IlyaBOT/Logic-Analyzer-Clock-Divider/previews/pcb_3d_back.png

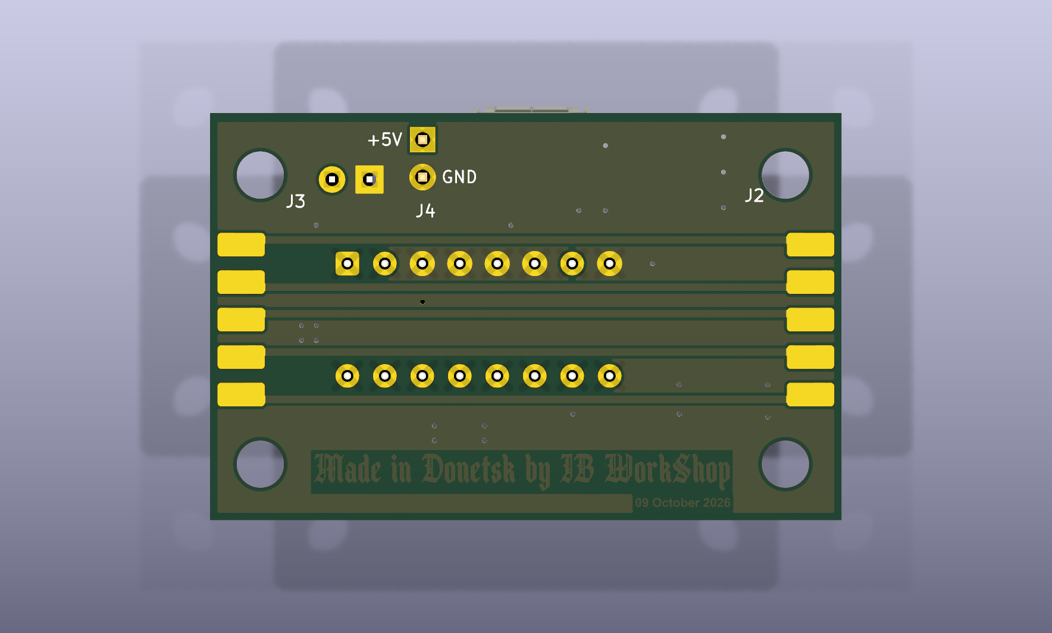
previews/pcb_3d_back.png
