IlyaBOT/Logic-Analyzer-Clock-Divider/previews/pcb_3d.png

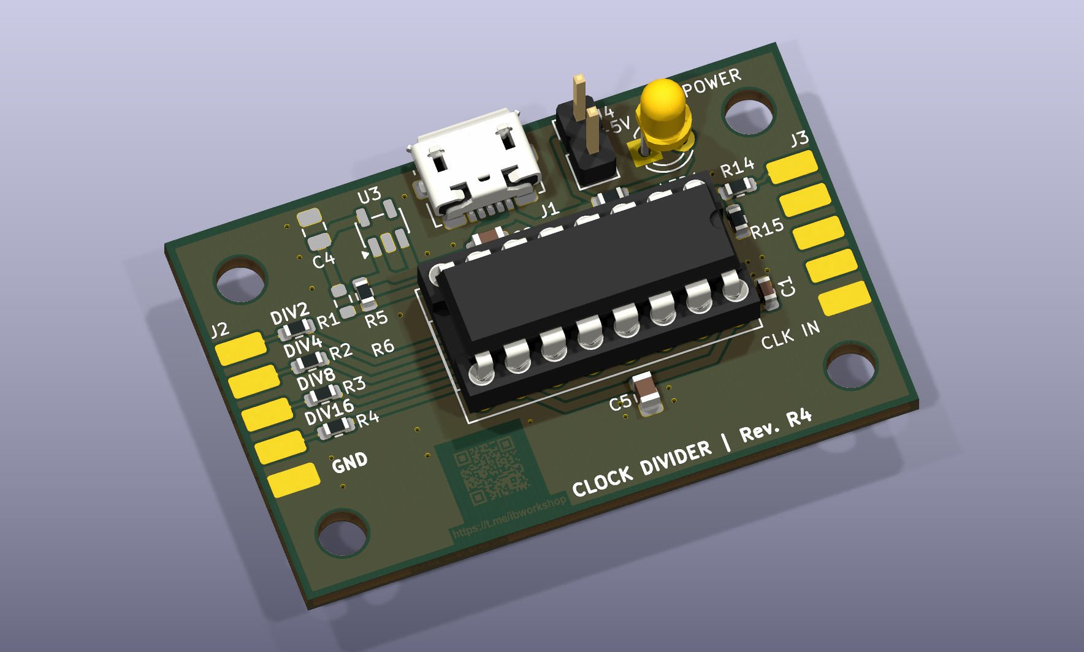
previews/pcb_3d.png
