IlyaBOT/Logic-Analyzer-Clock-Divider/README.md

# ACT161 Frequency Divider - R4

Основная редактируемая ревизия R4, KiCad 10.0.6, обновлена 2026-10-09. Прежняя папка R3 удалена. Взята ваша ручная разводка R4: все её дорожки/via, положения компонентов и контур сохранены. Текущий размер платы 42.8x27.6x1.6mm; два слоя, DIP-16/SCS-16 и четыре отверстия M3.

**До изготовления: оба торцевых разъёма UNVERIFIED, реальная распиновка/уровни анализатора неизвестны. Аппаратных измерений на 80MHz нет.**

Открыть `ACT161_Frequency_Divider.kicad_pro` в KiCad 10 или совместимой новой версии. Переносить всю папку: символы, footprint и модели локальные, пути `${KIPRJMOD}`. Схема и PCB нативные; генераторы не нужны для ручного редактирования.

## Изменения R4

J2 расположен на левой кромке, J3 - на правой. У каждого пять SMD-площадок F.Cu и пять B.Cu, без отверстий и без пасты. J3 больше не является нижним THT-разъёмом. Нечётные контакты обоих разъёмов на F.Cu, чётные на B.Cu; строки 1/2 сверху. Механические модели этих разъёмов отсутствуют: выполнена 2D-проверка, посадка реальных деталей не подтверждена.

SN74LVC125APW, C3 и выходные селекторные резисторы удалены. R1-R4=47R соединяют QA/QB/QC/QD напрямую с DIV2/4/8/16. По умолчанию U1 CD74ACT161E получает 5V через R5=0R; R6, U3, C4 не устанавливаются. LED питается от общей входной шины 5V (USB или J4). Пять PASS проходят напрямую между одинаковыми номерами J2/J3. USB +5V не соединено с контактами J2/J3.

## Питание проводами через J4

Между Micro-USB J1 и LED1 установлена вертикальная штыревая гребёнка J4 1x2, шаг 2.54mm, отверстия 1mm. При виде сверху, USB наверху: верхний квадратный контакт 1 = +5V, нижний круглый контакт 2 = GND. Полярность подписана на плате. Гребёнка включена в BOM и в схему, footprint и STEP локальные.

Подать стабилизированные 5V и общий GND от основной схемы. USB и J4 соединены с одной шиной напрямую: использовать только один источник за раз. При питании через J4 отключить USB-кабель, иначе питание может попасть в USB-порт. В опциональной сборке с выходами 3.3V на J4 по-прежнему подаются 5V; это вход до U3. LED работает от любого из этих двух входов.

В исходной R4 дополнены пять незавершённых соединений у J2/J3, исправлены пересечения/размер надписей и расстояние между QR и ссылкой. Исходные нативные файлы сохранены в `reports/user_R4_original.zip`; сравнение геометрии - `input_user_layout.json` и тест сохранения пользовательской разводки.

## Опция 3.3V без выходного буфера

Это отдельный вариант сборки с заменой U1, а не переключение напряжения установленного ACT161. При выключенном питании удалить R5, заменить CD74ACT161E в панельке на совместимый по выводам CD74AC161E, установить U3 TLV75533PDBVR, C4 и R6=0R. Все управляющие входы и развязка U1 питаются от выбранного VCC_LOGIC. Одновременно R5/R6 не устанавливать: это соединит 5V с выходом 3.3V стабилизатора.

CD74ACT161E требует 4.5-5.5V и не допускается в сборке 3.3V. Для CD74AC161E при 3.3V datasheet гарантирует до 64MHz (-55..125C), 73MHz (-40..85C), а не 80MHz. CLK должен быть 0..VCC и с полными CMOS-уровнями; 5V CLK напрямую запрещён в режиме 3.3V. Если 3.3V выходы нужны при 80MHz с сохранением ACT161, потребуется внешний преобразователь уровней либо отдельная переработка схемы. Источники и временные параметры в `reports/validation.md`.

## Проверки и файлы

Сохранённые ERC/DRC, 15 успешных тестов и `final_audit.txt` в `reports/` относятся к снимку из `checked_sha256.json`. Текущие PCB и `.kicad_pro` отличаются от этого снимка. Повторная проверка 2026-10-17: ERC без нарушений; DRC без ошибок, с одним предупреждением о несовпадении J4 с библиотечным footprint; тесты 13/15, два расхождения с прежней компоновкой. Подробности и список файлов для очистки — `reports/repository_audit.md`. Прежняя проверка переноса выполнялась в другой папке на этом же ПК, не на другой машине.

`docs/` содержит PDF схемы, двух copper и двух assembly видов, а также `pinout.md`. `previews/` содержит PNG, SVG каждого слоя и два настоящих 3D-рендера KiCad. BOM и варианты сборки в `reports/BOM.csv` и `assembly_variants.json`.

Чертежи и изображения относятся к исходникам, записанным в `reports/export_manifest.json`; после изменений PCB их нужно обновить. `.gitignore` исключает автокопии и локальные настройки KiCad, файлы Freerouting, кэши Python, старые генераторы и их логи. Нативные файлы, локальные библиотеки, документация, актуальные отчёты и `reports/user_R4_original.zip` остаются доступными для Git.

`scripts/check_native.py` запускает ERC/DRC/tests в этой установке KiCad. Старые генераторы `design.py` и `build_pcb.py` заблокированы от запуска, чтобы не перезаписать вашу ручную разводку. Нативные KiCad-файлы - основной источник проекта. `export.py` обновляет чертежи, `document.py` документацию. В скриптах заданы пути к установленным здесь KiCad/Poppler.

Перед подключением проверить pinout и допустимые уровни анализатора, посадку обоих торцевых разъёмов, точную панельку и приобретённые MLCC/LED. Подавать CLK после стабилизации питания; измерять питание и CLK у U1.2, начинать с низкой частоты. Выходы рассчитаны на высокоомные входы, не на DC-нагрузку 50ohm. В фазе включения счётчика нет определённого сброса. Прямой счёт 433MHz не предусмотрен. Gerber/Drill не выпускались, изготовление не заказывалось.
