IlyaBOT/Logic-Analyzer-Clock-Divider/docs/pinout.md

# Контакты, стороны и варианты R4

**До проверки документации/прозвонки конкретного анализатора J2 не подключать. Default выходы теперь 5V; 5V tolerance анализатора неизвестна.**

| Номер | J2 слева, анализатор | J3 справа, DUT |
|---|---|---|
| 1 | DIV2 | CLK_IN |
| 2 | PASS2 | PASS2 |
| 3 | DIV4 | NC |
| 4 | PASS4 | PASS4 |
| 5 | DIV8 | NC |
| 6 | PASS6 | PASS6 |
| 7 | DIV16 | NC |
| 8 | PASS8 | PASS8 |
| 9 | GND | GND |
| 10 | PASS10 | PASS10 |

PASS2/4/6/8/10 имеют только два узла J2.N/J3.N, без связи с USB-питанием, GND или счётчиком. Если контакт PASS анализатора является питанием, он напрямую попадёт на соответствующий контакт DUT: проверить возможный конфликт источников.

## Вид сверху, USB наверху

Плата 42.8x27.6mm. Координаты далее относительно верхнего левого угла: J2 - левая кромка X=0, J3 - правая X=42.8. В нативном PCB этот угол имеет координаты (126.6,84.4)mm. Оба разъёма припаяны к поверхности сверху/снизу, без отверстий. Начало координат слева сверху, Y направлен вниз.

| Строка Y, mm | J2 F.Cu | J2 B.Cu | J3 F.Cu | J3 B.Cu |
|---|---|---|---|---|
| 8.92 | 1 | 2 | 1 | 2 |
| 11.46 | 3 | 4 | 3 | 4 |
| 14.00 | 5 | 6 | 5 | 6 |
| 16.54 | 7 | 8 | 7 | 8 |
| 19.08 | 9 | 10 | 9 | 10 |

Центры J2 X=2.10, J3 X=40.70 (абсолютно 128.7 и 167.3mm). Площадки 3.20x1.60mm, шаг строк 2.54mm, край меди в 0.50mm от Edge.Cuts. Ни F.Paste, ни B.Paste нет; ручная пайка открытых площадок. J3 footprint является горизонтальным зеркалом геометрии J2 без изменения строк/номеров. Простое вращение J2 на 180 градусов поменяло бы верх/низ строк, поэтому для J3 сделан отдельный footprint.

Для вида снизу повернуть плату вокруг вертикальной оси, сохраняя USB сверху: J3 окажется слева, J2 справа, на обеих видимых поверхностях сверху вниз 2/4/6/8/10. PDF back отражён для этого вида. Эти номера относятся к площадкам PCB; порядок номеров на mating-стороне реальных разъёмов требует измерения.

U1: pin1 квадратный, вырез панельки направлен к J3. LED pin1=K, pin2=A. USB: 1 VBUS, 2 D-, 3 D+, 4 ID, 5 GND, SH экран (все SH на GND). R13=5.1k - R_LED, R14=0R - R_CLK, R15=10k - R_PD.

## J4 - альтернативный вход питания

| Контакт | Сеть | Положение при виде сверху, USB наверху |
|---|---|---|
| 1, квадратный | +5V | Верхний, X=28.40 / Y=1.80mm |
| 2, круглый | GND | Нижний, X=28.40 / Y=4.34mm |

Гребёнка 1x2, шаг 2.54mm, THT отверстия 1mm, находится между USB и LED. В нативном PCB центр pin1 (155.0,86.2)mm. Подавать стабилизированные 5V и GND. J4 напрямую связан с USB VBUS: подключать USB или J4 по отдельности, одновременно не питать. В опции 3.3V вход J4 остаётся 5V, напряжение U1 снижает U3. LED показывает наличие общей шины +5V от любого входа.

## Напряжение

| Сборка | U1 в панельке | Установить | Не устанавливать | Выходы |
|---|---|---|---|---|
| Default | CD74ACT161E | R5 | R6/U3/C4 | около 5V |
| Optional | CD74AC161E | R6/U3/C4 | R5 | около 3.3V |

Во втором варианте C4 эффективный >=1uF, U3 TLV75533PDBVR. Все изменения при отключённых USB и J4. R5 и R6 вместе запрещены; ACT161 при 3.3V запрещён. Предел второго варианта 64MHz во всём диапазоне температуры и CLK 0..VCC. Это вариант сборки с заменой IC, не рабочий переключатель напряжения. Совместимость с входами анализатора проверить в обоих случаях.

## Механика: оба UNVERIFIED

[CONNFLY DS1002](https://www.connfly.com/static/upload/file/pdf/DS1002-01.pdf) не подтверждает монтаж выбранного J2 на кромку. Для J3 не предоставлен MPN или чертёж male-разъёма такого монтажа. У обычных двухрядных разъёмов расстояние рядов 2.54mm, поверхности PCB находятся на расстоянии 1.6mm. Нужны замеры и при необходимости формовка выводов/фиксация корпуса. Проверить доступ к пайке, mating-нумерацию и удержание разъёмов. Если переделка штатных контактов непригодна, нужны предназначенные для торцевого монтажа разъёмы/переходники и повторная CAD-проверка. До этого статус изготовления HOLD.
