IlyaBOT/Logic-Analyzer-Clock-Divider/reports/repository_audit.md

# Аудит репозитория — 2026-10-17

Основной проект — нативные `ACT161_Frequency_Divider.kicad_sch`, `.kicad_pcb` и `.kicad_pro`. Локальные библиотеки, модели и их лицензия нужны для переноса проекта. `reports/user_R4_original.zip` и `input_user_layout.json` сохраняют исходную ручную разводку и базу сравнения; это полезные данные, а не временные копии.

## Очистка

Подтверждены 87 лишних или временных файлов, 8 727 313 байт. Все пути ниже заданы относительно `I:\Logic-Analyzer-Clock-Divider`:

| Путь | Файлов | Байт | Назначение |
|---|---:|---:|---|
| `ACT161_Frequency_Divider-backups/` | 78 | 8 602 977 | Автокопии KiCad до текущей ревизии |
| `scripts/__pycache__/` | 1 | 35 966 | Восстанавливаемый кэш Python |
| `reports/historical/` | 3 | 6 422 | Логи старой автоматической разводки и их описание |
| `ACT161_Frequency_Divider.kicad_prl` | 1 | 2 644 | Локальные настройки редактора |
| `temp-freerouting.dsn` | 1 | 43 163 | Промежуточный экспорт старой платы |
| `scripts/design.py` | 1 | 16 964 | Старый генератор схемы, запуск заблокирован |
| `scripts/build_pcb.py` | 1 | 13 694 | Старый генератор платы, запуск заблокирован |
| `scripts/add_power_header.py` | 1 | 5 483 | Однократная, уже применённая миграция J4 |

Действующие проверки, экспорт и документация не импортируют эти три старых скрипта. Все перечисленные пути исключены из Git. `.gitignore` также исключает новые автокопии, блокировки и автосохранения KiCad, обменные файлы Freerouting, Python-кэши, локальные окружения и системные метаданные. Полезные ZIP, PDF, STEP, изображения, JSON и отчёты общими правилами не скрываются.

**Удаление не выполнено:** автоматическая проверка отклонила как рекурсивную очистку по проверенному списку, так и удаление отдельных файлов без рекурсии. Сообщение инструмента: `rejected: blocked by policy`; более подробная причина не предоставлена. Перечисленные файлы остаются на диске. Изменён только учёт в Git и документация аудита.

## Проверка текущих исходников

Выполнены установленные KiCad CLI и Python/pcbnew, исходники платы не сохранялись и не исправлялись:

| Проверка | Результат |
|---|---|
| ERC, все уровни серьёзности | 0 нарушений, код 0 |
| DRC с проверкой соответствия схеме и пересчётом зон, без `--save-board` | 0 ошибок, 1 предупреждение, код 5 из-за `--exit-code-violations` |
| Несоединённые pads / schematic parity | 0 / 0 |
| `python.exe -B scripts/validate.py` | 13 из 15 успешно, код 1 |

Предупреждение DRC: `lib_footprint_mismatch` у J4, `PinHeader_1x02_P2.54mm_Vertical`, координаты (155.0000, 88.8000) mm. Footprint на плате отличается от локальной библиотеки. Это существовавшее до очистки расхождение.

Два упавших теста также обнаружены до изменений:

- `test_power_header_location_and_polarity`: шаг J4 по Y равен −2.54 mm вместо ожидаемых +2.54 mm. Отдельные проверки номеров контактов и сетей +5V/GND прошли до этого утверждения; ошибка относится к ориентации.
- `test_user_routing_and_placement_preserved`: одна из исходных позиций имеет Y=93.4 mm вместо 93.6 mm. Проверка всех исходных дорожек перед сравнением позиций прошла. Тест сравнивает с прежним снимком и не доказывает, что новое положение ошибочно.

Исходные отчёты CLI сохранены вне репозитория в `C:\Temp\clock-divider-audit-7d5883458e514ff1aa72f471ab3a168d\ERC.txt` и `DRC.txt`. Старые `reports/ERC.txt`, `DRC.txt`, `tests.txt`, `native_runs.json`, `portable_runs.json`, `final_audit.txt` и экспортированные изображения сохранены как результаты предыдущего снимка; повторная проверка переноса и экспорт не выполнялись.

## SHA256 на момент аудита

| Файл | SHA256 |
|---|---|
| `ACT161_Frequency_Divider.kicad_sch` | `dc645ffd8f1399dc9e17d4b2ce9c8c68495a97b33b39468b2b310f930c8ac9fd` |
| `ACT161_Frequency_Divider.kicad_pcb` | `d1fae81a477b3b5089f1d526dd3a74267afd06d627be29f03f2725eed6305038` |
| `ACT161_Frequency_Divider.kicad_pro` | `f69a45ea37f27b7f60f324420965d9941e6eb511919465da47709639cdfab9a8` |

Схема совпадает с прежним `checked_sha256.json`. Плата и проект не совпадают ни с ним, ни с `export_manifest.json`, поэтому прежние PASS и чертежи нельзя считать подтверждением текущей версии. Разводка, настройки и тестовые ожидания не менялись ради получения PASS.

После работы SHA256 всех исходных файлов совпадают с исходным состоянием, кроме намеренно обновлённых `README.md`, `reports/validation.md` и `scripts/document.py`. Нативные CAD-файлы, библиотеки, исходный ZIP, чертежи и изображения сохранены побайтно. Добавлены `.gitignore` и этот отчёт. Проверка `git check-ignore --no-index --stdin -z` подтвердила: скрыты ровно 87 перечисленных файлов, остальные 76 файлов доступны Git; дополнительно проверены 18 примеров будущих временных путей. Синтаксис шести действующих Python-скриптов и отсутствие импортов старых генераторов проверены через AST. `git diff --check` прошёл.
