IlyaBOT/Logic-Analyzer-Clock-Divider/docs/schematic.pdf

1 | 2 | 3 | 4 | 5 | 6 | 7 | 8
1 | 2 | 3 | 4 | 5 | 6 | 7 | 8

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
Size: A3 | Rev: R4 | F Date: 2026-10-09
KiCad E.D.A. 10.0.6 | Id: 1/1

# Title: 74ACT161 Frequency Divider

## File: ACT161_Frequency_Divider.kicad_sch

## Sheet: /

## Engineering prototype - UNVERIFIED edge connectors / analyzer

#FLG01 PWR_FLAG

H3 M3 / 3.2mm

1
2

J4
5V POWER INPUT

H2 M3 / 3.2mm

IN 1 GND

2

EN 3 | OUT | 5

U3
TLV75533PDBVR / 3V3 OPTION CLR 1 | CLK 2
A 3 | B
4 | C
5 | D
6
ENP 7 | GND

8

LOAD 9

ENT 10 | QD | 11 QC | 12 QB | 13 QA | 14 RCO | 15 VCC 16
U1 CD74ACT161E | R1 47R

R14
0R (0-100R option) | H1 M3 / 3.2mm

C4

4.7u / 16V X7R / DNP VBUS | 1 D- | 2 D+ | 3
ID | 4 GND

# 5 Shield SH

J1 Molex 47346-0001

LED1
YELLOW 3mm

R5
0R / 5V DEFAULT | R2
47R 1 | 2
3 | 4
5 | 6
7 | 8
9 | 10

J3 DUT / male 2x5 EDGE UNVERIFIED

R6
0R / 3V3 OPTION

C5
1u / 16V X7R

R15
10k 1 | 2
3 | 4
5 | 6
7 | 8
9 | 10

J2 DS1002-01-2x5V13-JK / EDGE UNVERIFIED

R3
47R

R4
47R

C2
4.7u / 16V X7R

C1
100n / 25V X7R

H4 M3 / 3.2mm

R13
5.1k

DIV16 GND

VCC_LOGIC +5V

PASS4

+5V | Q8Q4 GND | Q2Q16
LED_A

VCC_LOGIC

GND | +5V
VCC_LOGIC +5V | GND
VCC_LOGIC +5V | GND

GND

GND

+3V3

LED_A DIV2 GND +3V3 | DIV4
+5V +3V3 | +5V GND

GND

VCC_LOGIC

VCC_LOGIC

CLK_U1 DIV2 | PASS2 DIV4 | Q16 DIV8 DIV16 GND

PASS6

Q4 PASS8 PASS10 | CLK_IN
Q2 PASS4 | Q8 PASS6
DIV8 GND | PASS10 PASS2 PASS8
CLK_IN | CLK_U1 CLK_U1 GND

VCC_LOGIC

VCC_LOGIC

VCC_LOGIC

VCC_LOGIC

GND

GND

## GND 1. USB / J4 POWER AND OPTIONAL 3.3 V SUPPLY

## 5 V DEFAULT | no output buffer | two opposing edge connectors

# 74ACT161 FREQUENCY DIVIDER - R4

Output levels follow VCC_LOGIC. No SN74LVC125APW on this board. 3. DIRECT OUTPUTS / SERIES DAMPING

R5 fitted: VCC_LOGIC = input 5 V (default). R6/U3/C4 DNP. 3.3 V: REMOVE R5, fit R6/U3/C4 and REPLACE U1 with CD74AC161E. Never power CD74ACT161E from 3.3 V. Never fit R5 and R6 together.

## 2. CLOCK AND COUNTER

QA -> /2

J4: regulated 5 V input. USB OR J4; use only one power source. No power-on reset: startup phase is undefined. C1 next to U1 pin 16. PASS2/4/6/8/10 direct; no USB power on J2/J3. No 433 MHz support.

QB -> /4

## 4. CONNECTORS AND MOUNTING

ACT / 5 V: TTL CLK; VIH >= 2 V, VIL <= 0.8 V; target up to 80 MHz. | QC -> /8

QD -> /16

Both mechanical interfaces UNVERIFIED. Confirm mating pin numbers. J2 LEFT EDGE, J3 RIGHT EDGE: 5 pads on F.Cu + 5 on B.Cu each. AC / 3.3 V option: CLK 0..VCC; limit 64 MHz over -55..125 C.
