IlyaBOT/Logic-Analyzer-Clock-Divider/previews/pcb_back.png

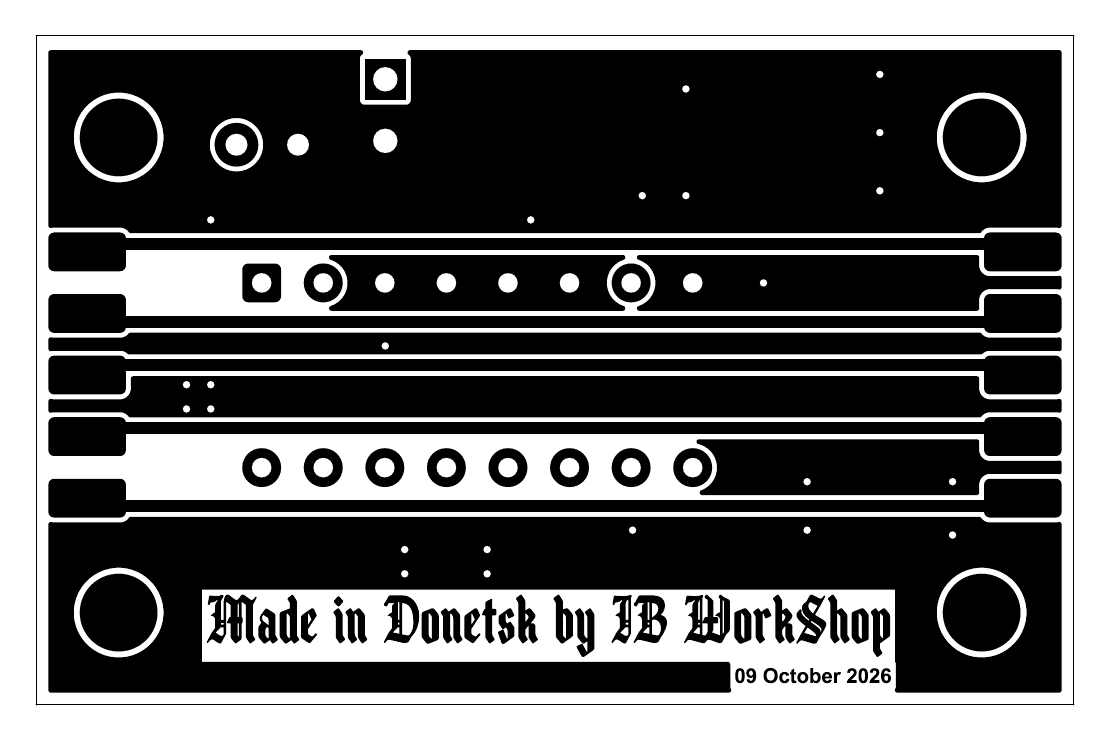
previews/pcb_back.png
