IlyaBOT/Logic-Analyzer-Clock-Divider/previews/pcb_front.png

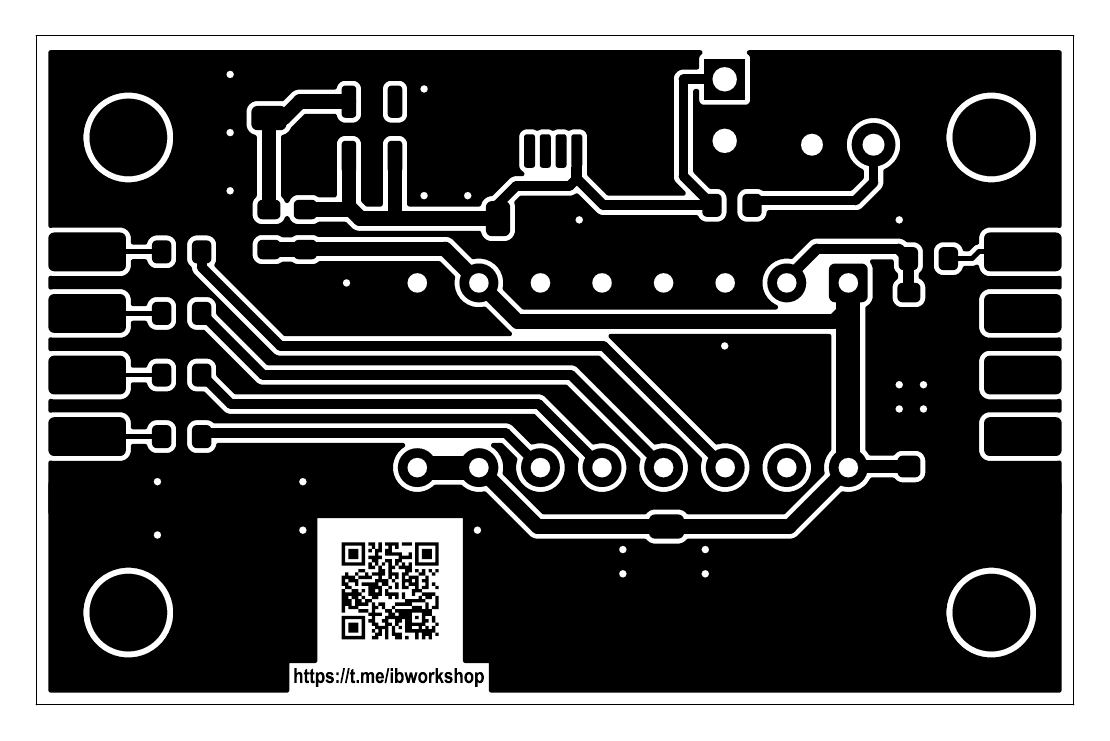
previews/pcb_front.png
