IlyaBOT/Logic-Analyzer-Clock-Divider/previews/schematic.png

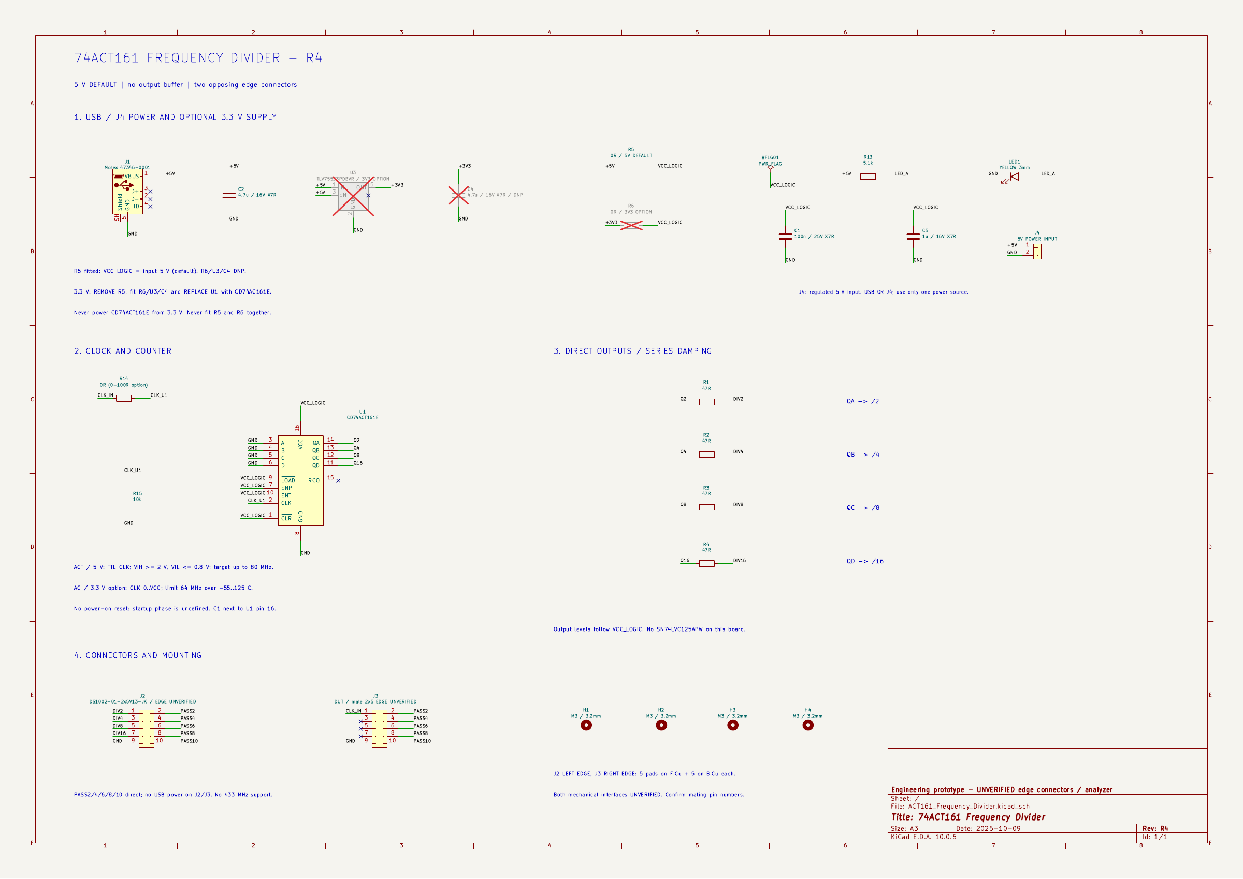
previews/schematic.png
