IlyaBOT/Logic-Analyzer-Clock-Divider/previews/assembly_back.png

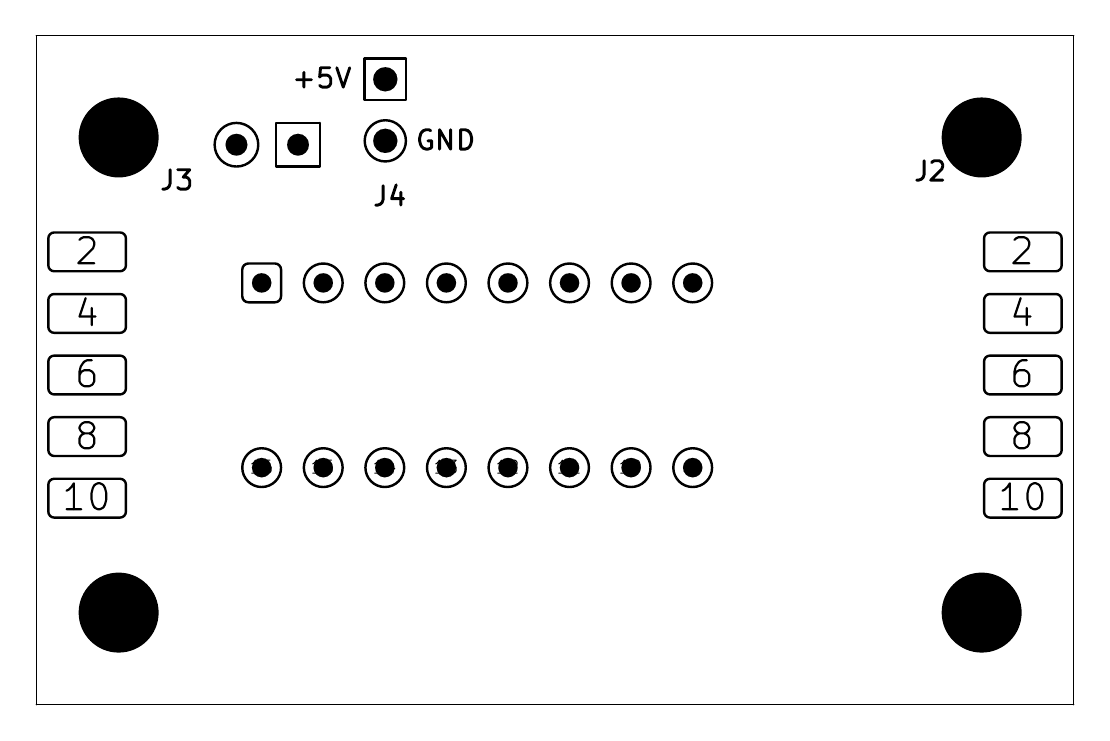
previews/assembly_back.png
