IlyaBOT/Logic-Analyzer-Clock-Divider/previews/assembly_front.png

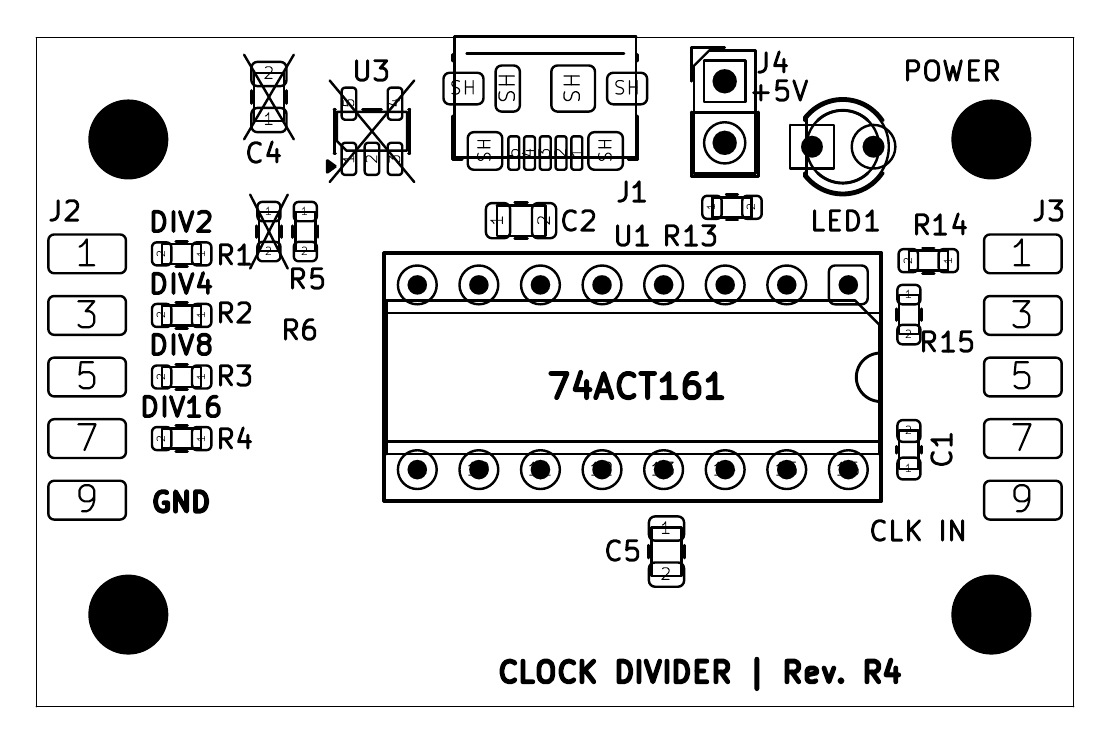
previews/assembly_front.png
