IlyaBOT/Logic-Analyzer-Clock-Divider/reports/validation.md

# Проверка R4 - 2026-10-09

Это исторический отчёт для снимка `checked_sha256.json`. Текущие PCB и настройки проекта отличаются; результаты повторной проверки от 2026-10-17 находятся в [repository_audit.md](repository_audit.md).

Windows, установленный KiCad 10.0.6 и bundled pcbnew/Python. Ручная R4 сделана основной, прежняя папка R3 удалена. Добавлен J4 и завершены пять соединений у торцевых разъёмов. Все 108 исходных дорожек/via, позиции всех 23 исходных компонентов и контур сохранены (отдельный тест по UUID и геометрии). Исходные native-файлы архивированы в user_R4_original.zip; входной DRC с 14 нарушениями и 5 unconnected сохранён как input_user_DRC.txt. Это CAD-проверка; собранное устройство не испытано.

## Результаты

| Проверка | Фактический результат |
|---|---|
| ERC `--severity-all --exit-code-violations` | 0 ошибок, 0 предупреждений; exit0 |
| DRC `--schematic-parity --all-track-errors --severity-all --refill-zones` | 0 ошибок, 0 предупреждений; exit0 |
| Несоединённые pads / schematic parity | 0 / 0 |
| Netlist и физические pad nets | Все контакты сверены с ожидаемыми сетями |
| U1/U3 pin maps | Сверены с официальными TI datasheet |
| PASS / USB или J4 power | Прямые пары одинаковых номеров, питания на J2/J3 нет |
| Разъёмы | Оба edge SMD: odd F.Cu / even B.Cu, никаких отверстий/paste |
| Счёт/деление/управление | 4 логических теста, 4096 сценариев управления, 256 тактов, все начальные фазы |
| Общий testbench | 15/15 успешно, включая J4 и сохранение разводки, `tests.txt` |
| PDF/SVG/3D | Нативный экспорт KiCad, PNG Poppler, визуальная проверка обеих сторон |
| Финальный аудит | `final_audit.txt`: hash, комплект, courtyard, via centers, mask, локальные модели |
| Перенос | Другая папка на этом же ПК; ERC/DRC/parity0, `portable_runs.json` |

Команды и настоящие коды возврата в `native_runs.json`, SHA256 нативных файлов в `checked_sha256.json`. Исключения DRC пусты; пользовательские настройки сохранены, критические проверки имеют уровень error. Стандартная таблица rule_severities, записанная GUI KiCad, сохранена. Минимумы: clearance0.20, silk0.15, width0.20, via0.60, edge0.50mm; фактические via0.65/drill0.30mm. Минимумы проверены в сохранённом проекте. Стандартные Ignored checks KiCad: отсутствующий courtyard, via centering, tuning geometry, symbol filters, footprint types. Все footprint имеют courtyard, pad types/номера и центры сигнал-via проверены отдельным аудитом. Исключённых нарушений нет.

## Почему удалён SN74LVC125APW

В R3 он преобразовывал 5V счётчика в 3.3V, что было выбрано как default. По новым требованиям default5V, поэтому U2, C3 и 8 выходных связок удалены. QA..QD теперь через R1..R4=47R подключены к J2. Установленная default схема содержит один активный логический IC U1. U3/C4/R6 - места под опцию, в default DNP. Схема содержит PWR_FLAG на VCC_LOGIC: ERC не проводит питание сквозь пассивную перемычку R5.

## Проверка электрических режимов

[TI CD74ACT161, SCHS298B](https://www.ti.com/lit/ds/symlink/cd74act161.pdf): питание4.5-5.5V, TTL CLK VIH>=2V/VIL<=0.8V, вход0..VCC. Pin1=/CLR,2=CLK,3..6=A..D,7=ENP,8=GND,9=/LOAD,10=ENT,11..14=QD/QC/QB/QA,15=RCO,16=VCC. /CLR,/LOAD,ENP,ENT и VCC связаны с VCC_LOGIC; A..D к GND, RCO NC. CLK положительный фронт. При запуске без clear фаза неизвестна. Default R5 соединяет общую шину входа USB/J4 +5V с VCC_LOGIC.

Для ACT полный температурный диапазон -55..125C: fclock80MHz, CLK high/low>=6.2ns, clear low>=6ns, setup data5ns/load6ns, recovery6ns, hold data/ENP/ENT0ns; tpd CLK-Q<=16.5ns при CL50pF. Для 80MHz T12.5ns, duty49.6-50.4%; при 50% запас на каждом полупериоде всего0.05ns. Реальный источник/фронты/нагрузка и питание требуют осциллографа. Подача сигнала при отключённом U1 может питать его через защитные диоды.

[TI CD74AC161, SCHS239D от 2024-05](https://www.ti.com/lit/gpn/CD74AC161): PDIP E и pinout совпадают с ACT, питание1.5-5.5V. При 3.3V+/-0.3V и CL50pF fmax64MHz (-55..125C),73MHz (-40..85C); CLK high/low>=7.7ns для полного диапазона, clear low>=7ns. Именно CD74AC161E является заменой U1 для опции3.3V. CLK должен оставаться в0..VCC с полными CMOS-уровнями, 5V CLK напрямую недопустим. Предел80MHz для этого режима не гарантирован. Не подавать3.3V на CD74ACT161E.

[TI TLV755P](https://www.ti.com/lit/ds/symlink/tlv755p.pdf): U3 SOT23-5 IN1=+5V, GND2, EN3=+5V, NC4,OUT5=+3V3. C2/C4 должны иметь эффективные>=1uF при bias/температуре. Для опции удалитьR5, установитьU3/C4/R6, заменитьU1. R5/R6 вместе закоротят разные источники: запрещено. Данные о вариантах сборки в `assembly_variants.json`; PCB и схема отражают default сборку.

[USB Molex SD-47346-001](https://www.molex.com/content/dam/molex/molex-dot-com/products/automated/en-us/salesdrawingpdf/473/47346/473460001_sd.pdf): стандартный footprint/model KiCad47346-0001. D-/D+/ID NC, все SH наGND. USB5V не выведено на J2/J3. Default входная ёмкость около5.8uF (C2+C5+C1); оценка, не USB сертификация. LED cathode1 кGND, anode2 черезR13=5.1k к общей шине USB/J4 +5V: около0.59mA приVf2V. Светодиод подтверждает наличие входных 5V от USB или J4, а не VCC_LOGIC.

R14 default0R; опция100R при Cin U1до10pF даёт tau1ns только по IC, поэтому требует измерения на80MHz. R15=10k удерживает CLK без источника, статический ток0.5mA при5V. R1..R4=47R начальные демпфирующие значения: tau0.47ns при10pF,2.35ns при50pF без сопротивления драйвера. Высокоомный анализатор, согласование/нагрузка/звон не проверены аппаратно. Резисторы расположены по пути к J2; контролируемое волновое сопротивление/идеальное согласование источника не заявляются. Буферных DNP-ответвлений R3 больше нет.

## Плата

42.8x27.6x1.6mm, площадь1181.28mm2. Контур пользовательской R4 сохранён. Два слоя; B.Cu194.4mm (48.6% длины),F.Cu205.6mm. Via всего23,GND23,остальные0. Всех необходимых соединений трассировка завершена. GND заливка на обеих сторонах с удалением всех изолированных островков и stitching-via возле развязки/CLK и между участками. Обратный путь B.Cu преимущественно F.Cu; количественная SI/EMI-проверка не проведена.

Минимальная дорожка0.20mm/clearance0.20mm; подключение J4 +5V дорожкой0.40mm, copper edge0.50mm, via0.65/0.30mm. При35um меди 30mm трассы0.20mm дают около0.075ohm (3.75mV при50mA). Расчётный ток U1 по типичному Cpd66pF при80MHz/5V около26.4mA без внешней нагрузки. Это расчёты, не измерения. Маска expansion0.05mm/minimum web0.10mm. C1 рядом с U1.16; четыре NPTH3.2mm с envelope6.4mm свободны от courtyard компонентов, трассы обходят монтажные зоны.

## Визуальная проверка и механика

PDF схемы, copper обеих сторон и assembly экспортированы KiCad, затем Poppler PNG. Отдельные SVG F.Cu/B.Cu/F.Silkscreen/B.Silkscreen/Edge.Cuts в `previews/layers`. 3D-рендеры нативные KiCad: DIP и socket, USB, жёлтый LED, новый штыревой J4 1x2, DNP скрыты. Socket подъём IC3.5mm - номинальная модель, точная SCS-16 не подтверждена. LED модель generic, не закупочный MPN. Интерактивный GUI и физическая сборка не использовались как доказательства.

У обоих разъёмов 5F+5B площадок, no holes/paste. Относительно верхнего левого угла J2 X2.1,J3 X40.7; Y8.92+2.54i, pad3.2x1.6mm, copper setback0.5mm. Fodd/Beven у обоих, строки не перевёрнуты. Mating-номера конкретных деталей неизвестны. Для J2 [CONNFLY чертёж](https://www.connfly.com/static/upload/file/pdf/DS1002-01.pdf) не подтверждает торцевой монтаж V/T. У J3 нет предоставленного maleMPN. Предварительная толщина1.6mm не совпадает с межрядным шагом2.54mm: нужны измерения/формовка и фиксация. У обоих нет утверждённых 3D-моделей, проверка площадок только2D.

## Открытые ограничения

1. Оба разъёма UNVERIFIED: подтвердить детали, посадку, толщину, пайку и mating-нумерацию. При несовместимости нужен специальный edge connector либо переходник и новый CAD-check.
2. Анализатор неизвестен: проверить реальные номера,GND,PASS и допустимые напряжения. Default5V не является заявлением о его 5V tolerance.
3. Опция3.3V требует заменыU1 и ограничения частоты/CLK, а не простой перестановки одной перемычки. Нет гарантии80MHz для AC3.3V; ACT3.3V запрещён.
4. Точная SCS-16/LED и MLCC effectiveC требуют проверки закупочных MPN. CAD-модели их не подтверждают.
5. Логическая симуляция4096 сценариев/256 тактов не моделирует задержки/фронты и не доказывает физические80MHz. Нужны реальные измерения питания, счёта, CLK, звона, нагрузки и нагрева. 433MHz напрямую не поддерживается.
6. Другой ПК не проверен. Gerber/Drill не выпускались, плата не заказывалась. Статус производства HOLD.
