IlyaBOT/Logic-Analyzer-Clock-Divider/docs/assembly_back.pdf

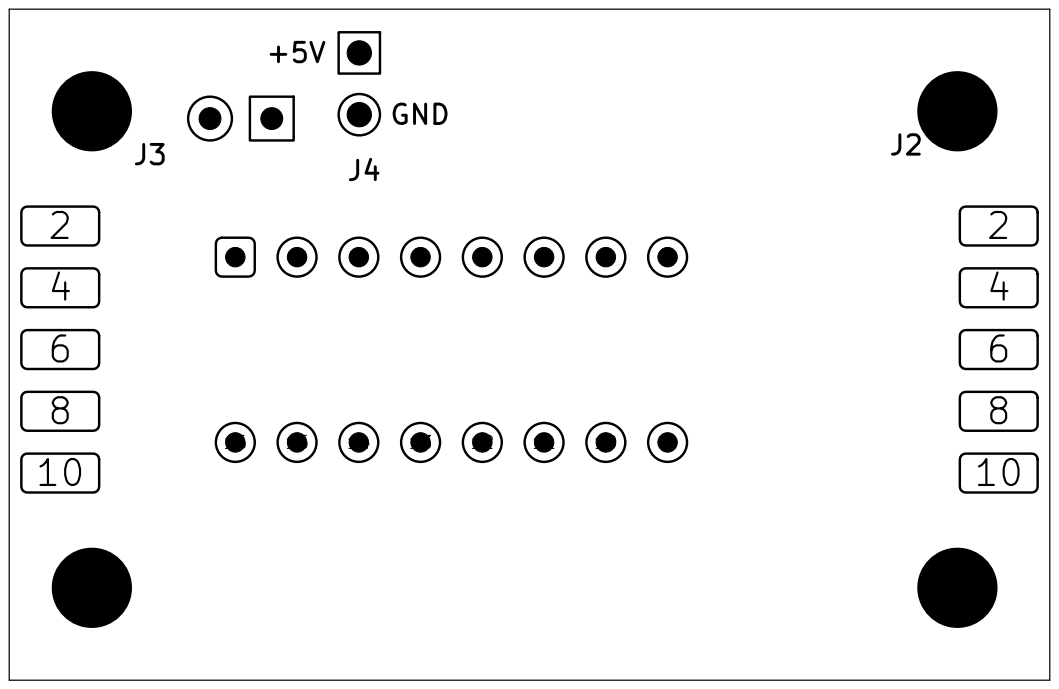
[picture p8: page 1]
