IlyaBOT/Logic-Analyzer-Clock-Divider/docs/assembly_front.pdf

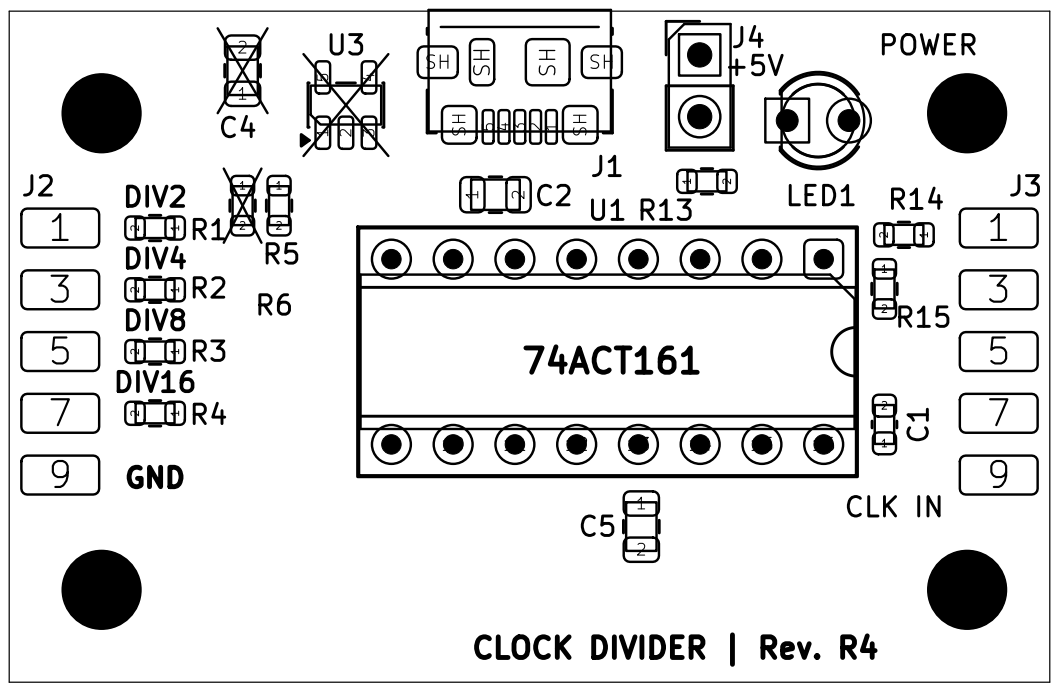
[picture p9: page 1]
