IlyaBOT/Logic-Analyzer-Clock-Divider/docs/pcb_back.pdf

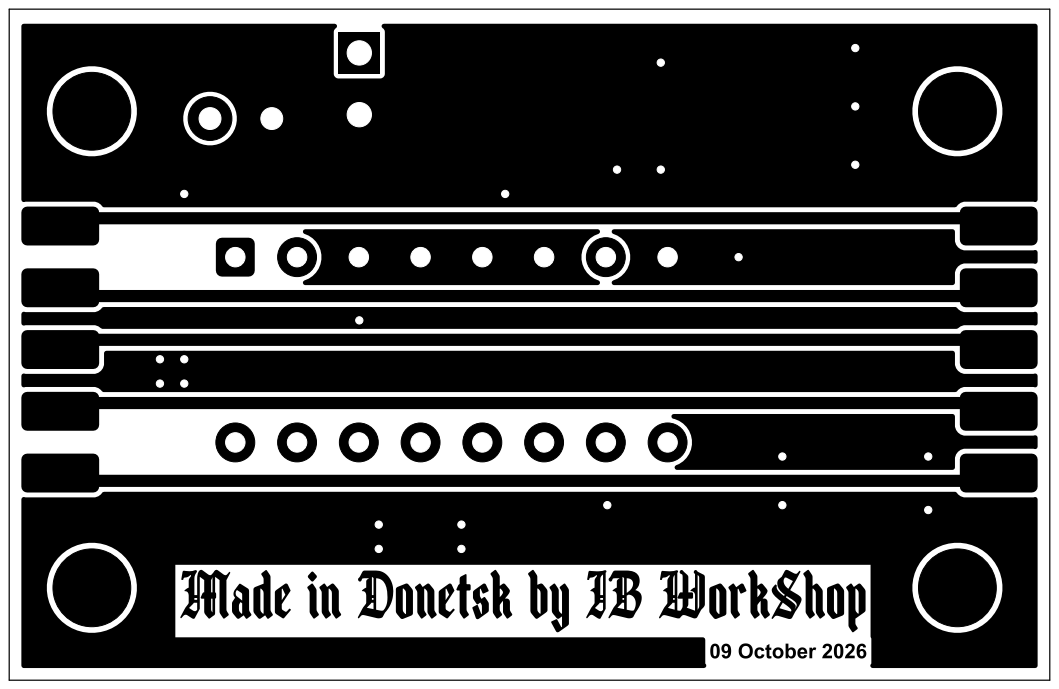
[picture p10: page 1]
