IlyaBOT/Logic-Analyzer-Clock-Divider/docs/pcb_front.pdf

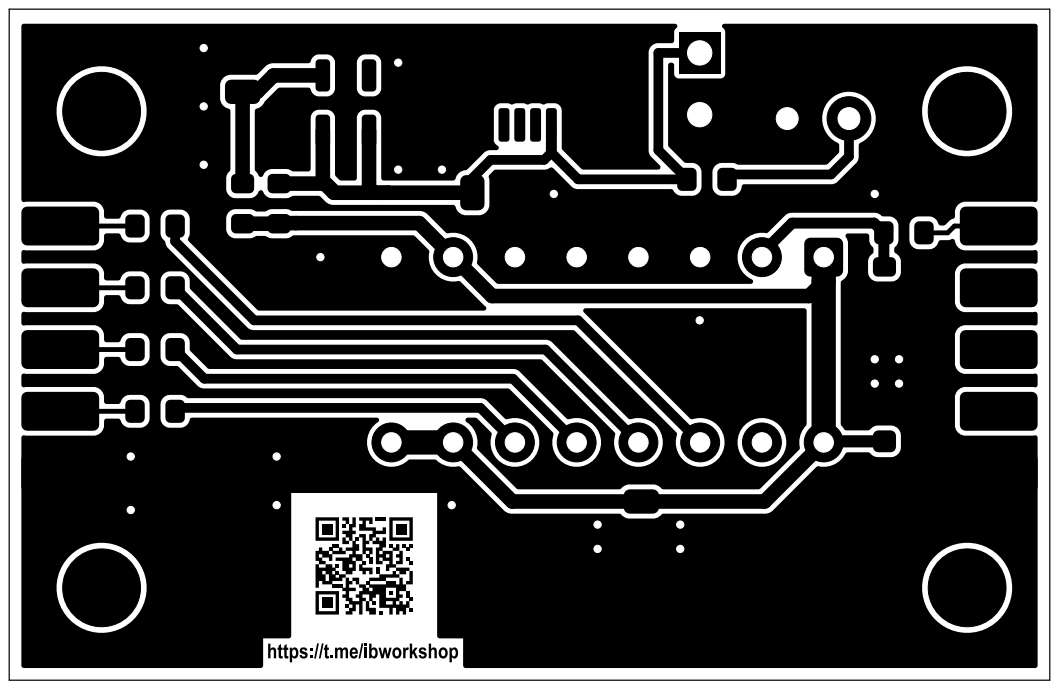
[picture p11: page 1]
