IlyaBOT/Logic-Analyzer-Clock-Divider/ACT161_Frequency_Divider.kicad_pcb

## KiCad design ACT161_Frequency_Divider.kicad_pcb (2026-10-16)

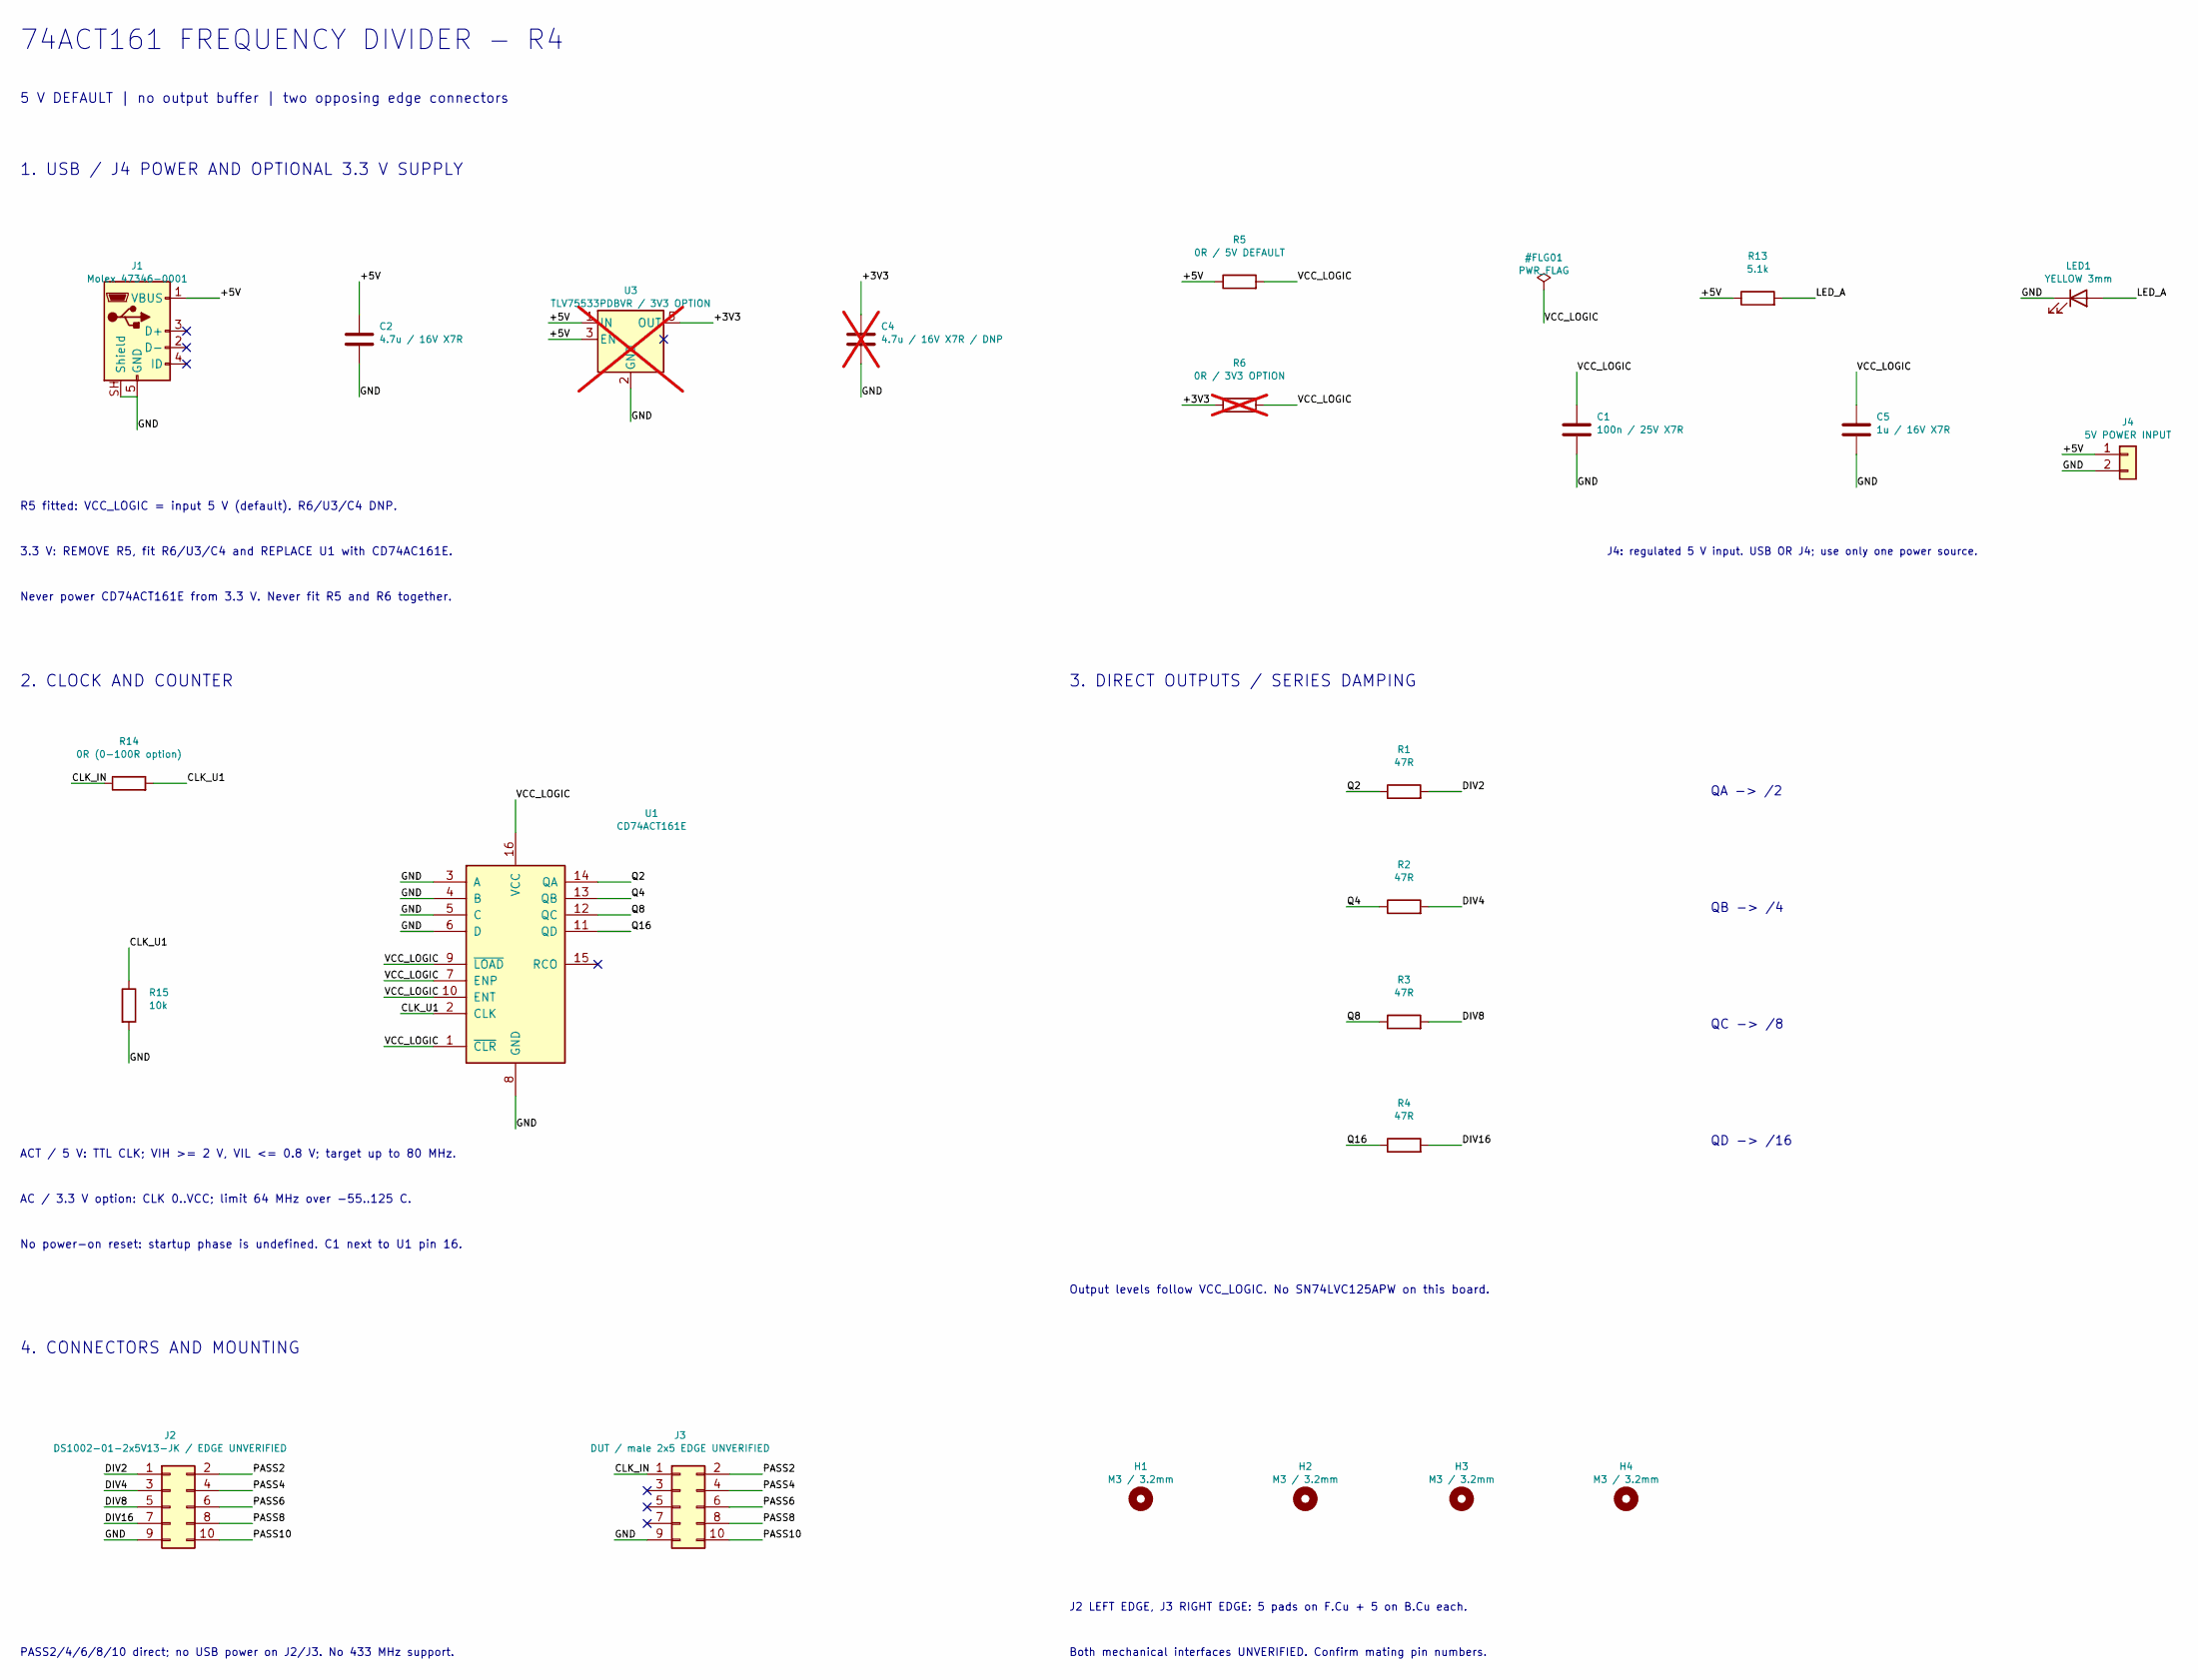
[picture p12: schematic ACT161_Frequency_Divider.kicad_sch, 74ACT161 Frequency Divider]

Parts:
C1: 100n / 25V X7R; C_0603_1608Metric
C2: 4.7u / 16V X7R; C_0805_2012Metric
C4: 4.7u / 16V X7R / DNP; C_0805_2012Metric; not fitted
C5: 1u / 16V X7R; C_0805_2012Metric
H1, H2, H3, H4: M3 / 3.2mm; MountingHole_3.2mm_M3
J1: Molex 47346-0001; USB_Micro-B_Molex_47346-0001
J2: DS1002-01-2x5V13-JK / EDGE UNVERIFIED; J2_Edge_2x05
J3: DUT / male 2x5 EDGE UNVERIFIED; J3_Edge_2x05
J4: 5V POWER INPUT; PinHeader_1x02_P2.54mm_Vertical
LED1: YELLOW 3mm; LED_D3.0mm
R1, R2, R3, R4: 47R; R_0603_1608Metric
R5: 0R / 5V DEFAULT; R_0603_1608Metric
R6: 0R / 3V3 OPTION; R_0603_1608Metric; not fitted
R13: 5.1k; R_0603_1608Metric
R14: 0R (0-100R option); R_0603_1608Metric
R15: 10k; R_0603_1608Metric
U1: CD74ACT161E; DIP-16_W7.62mm_Socket
U3: TLV75533PDBVR / 3V3 OPTION; SOT-23-5; not fitted

Connections:
/+3V3: C4.1, R6.1, U3.5 (OUT)
/+5V: C2.1, J1.1 (VBUS), J4.1, R5.1, R13.1, U3.1 (IN), U3.3 (EN)
/CLK_IN: J3.1, R14.1
/CLK_U1: R14.2, R15.1, U1.2 (CLK)
/DIV2: J2.1, R1.2
/DIV4: J2.3, R2.2
/DIV8: J2.5, R3.2
/DIV16: J2.7, R4.2
/GND: C1.2, C2.2, C4.2, C5.2, J1.5 (GND), J1.SH (Shield), J2.9, J3.9, J4.2, LED1.1 (K), R15.2, U1.3 (A), U1.4 (B), U1.5 (C), U1.6 (D), U1.8 (GND), U3.2 (GND)
/LED_A: LED1.2 (A), R13.2
/PASS2: J2.2, J3.2
/PASS4: J2.4, J3.4
/PASS6: J2.6, J3.6
/PASS8: J2.8, J3.8
/PASS10: J2.10, J3.10
/Q2: R1.1, U1.14 (QA)
/Q4: R2.1, U1.13 (QB)
/Q8: R3.1, U1.12 (QC)
/Q16: R4.1, U1.11 (QD)
/VCC_LOGIC: C1.1, C5.1, R5.2, R6.2, U1.1 (~CLR), U1.7 (ENP), U1.9 (~LOAD), U1.10 (ENT), U1.16 (VCC)

Notes on the sheet:
74ACT161 FREQUENCY DIVIDER - R4
5 V DEFAULT | no output buffer | two opposing edge connectors
1. USB / J4 POWER AND OPTIONAL 3.3 V SUPPLY
R5 fitted: VCC_LOGIC = input 5 V (default). R6/U3/C4 DNP.
3.3 V: REMOVE R5, fit R6/U3/C4 and REPLACE U1 with CD74AC161E.
Never power CD74ACT161E from 3.3 V. Never fit R5 and R6 together.
2. CLOCK AND COUNTER
ACT / 5 V: TTL CLK; VIH >= 2 V, VIL <= 0.8 V; target up to 80 MHz.
AC / 3.3 V option: CLK 0..VCC; limit 64 MHz over -55..125 C.
No power-on reset: startup phase is undefined. C1 next to U1 pin 16.
3. DIRECT OUTPUTS / SERIES DAMPING
QA -> /2
QB -> /4
QC -> /8
QD -> /16
Output levels follow VCC_LOGIC. No SN74LVC125APW on this board.
4. CONNECTORS AND MOUNTING
J2 LEFT EDGE, J3 RIGHT EDGE: 5 pads on F.Cu + 5 on B.Cu each.
Both mechanical interfaces UNVERIFIED. Confirm mating pin numbers.
PASS2/4/6/8/10 direct; no USB power on J2/J3. No 433 MHz support.
J4: regulated 5 V input. USB OR J4; use only one power source.

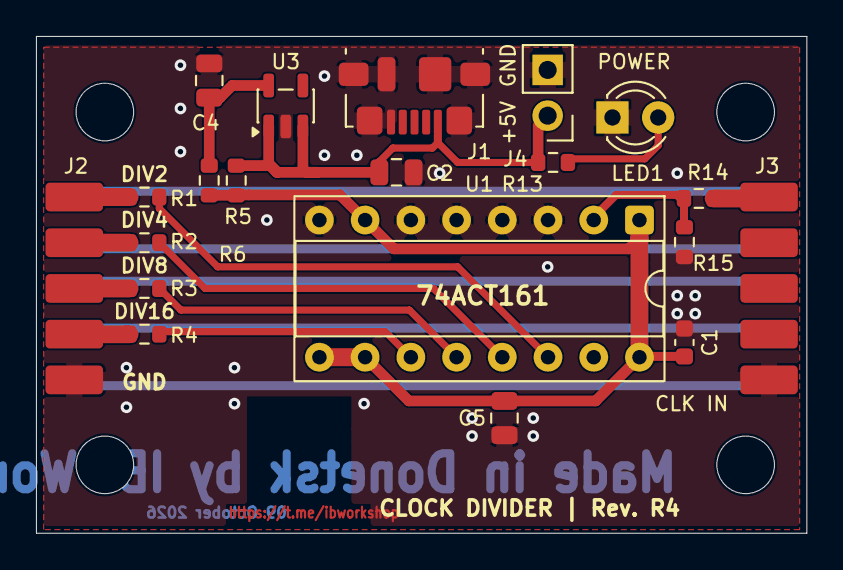
[picture p13: board ACT161_Frequency_Divider.kicad_pcb from above]

Board: 2 copper layers, 42.8 x 27.6 mm, 24 parts (0 on the bottom side), 20 nets.
